tdorssers/Robot2/schematic/Robot2.sch

## EAGLE design schematic/Robot2.sch (2022-09-24)

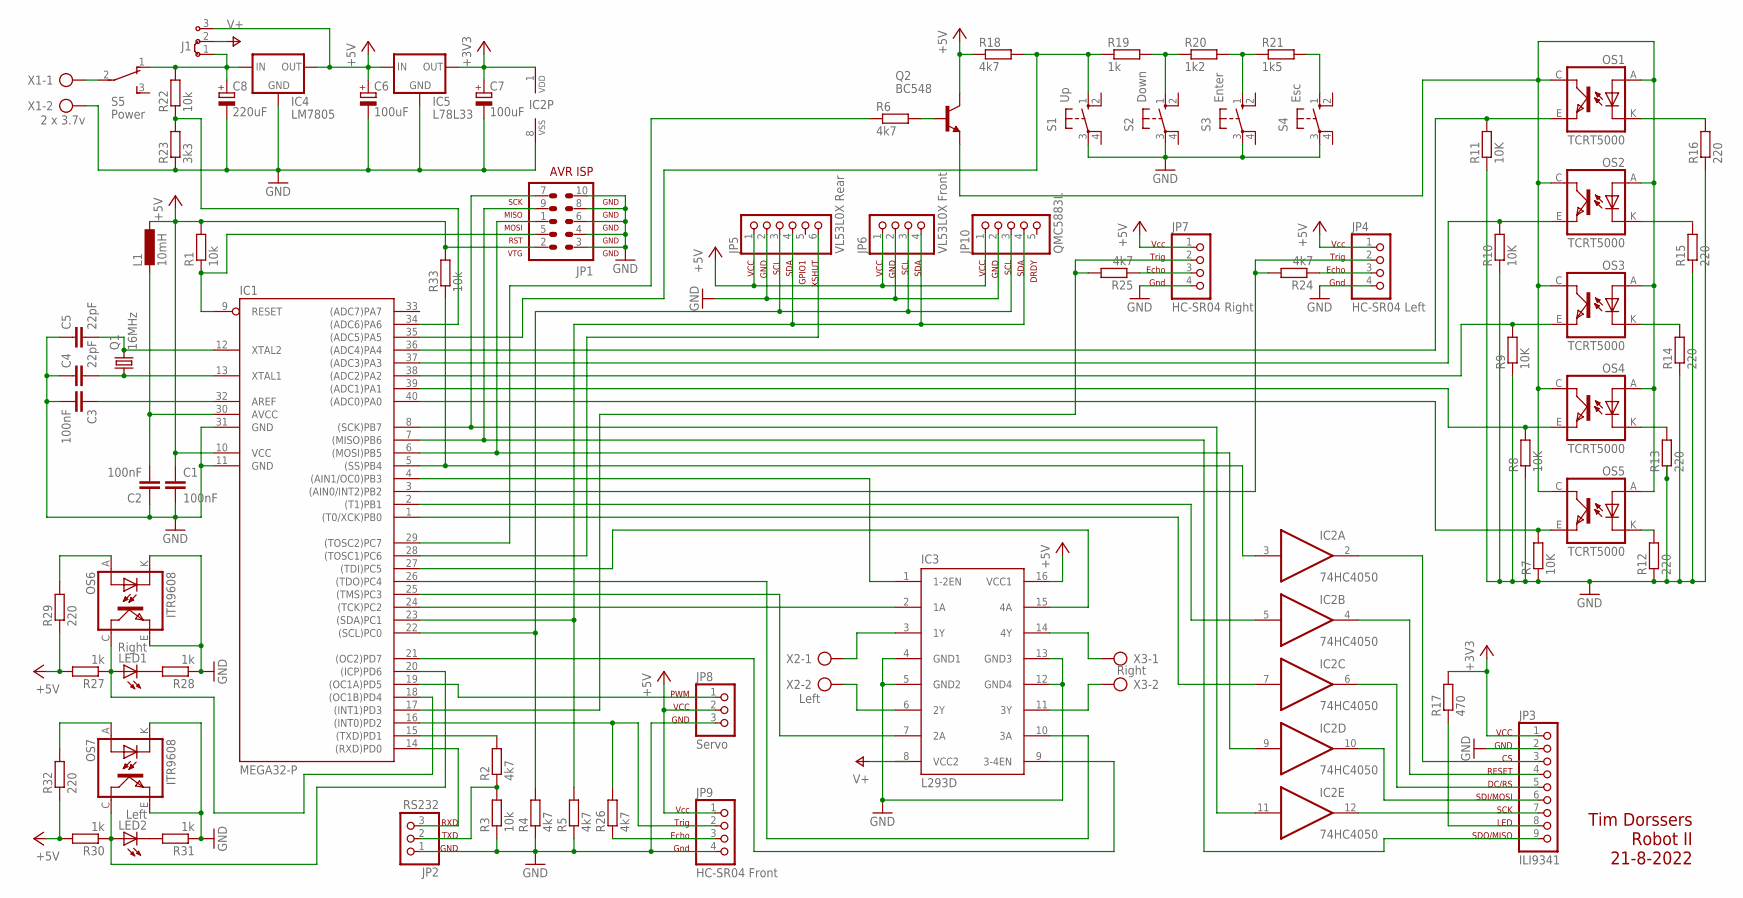
[picture p4: schematic Robot2.sch]

Parts:
C1, C2, C3: 100nF; C050-025X075
C4, C5: 22pF; C025-024X044
C6, C7: 100uF; B45181A
C8: 220uF; B45181A
IC1: MEGA32-P; DIL40
IC2: 74HC4050; DIL16
IC3: L293D; DIL16
IC4: LM7805; 78XXL
IC5: L78L33; 78LXX
J1: J2X2MM; 04C
JP1: AVR-ISP-10
JP2: RS232; 1X03
JP3: ILI9341; 1X09
JP4: HC-SR04 Left; 1X04
JP5: VL53L0X Rear; 1X06
JP6: VL53L0X Front; 1X04
JP7: HC-SR04 Right; 1X04
JP8: Servo; 1X03
JP9: HC-SR04 Front; 1X04
JP10: QMC5883L; 1X05
L1: 10mH; 0207/10
LED1: Right; LED5MM
LED2: Left; LED5MM
OS1, OS2, OS3, OS4, OS5: TCRT5000
OS6, OS7: ITR9608; TCRT5000
Q1: 16MHz; HC49U-V
Q2: BC548; TO92-EBC
R1, R3, R22, R33: 10k; 0207/2V
R2, R4, R5, R6, R18, R24, R25, R26: 4k7; 0207/2V
R7, R8, R9, R10, R11: 10K; 0204/7
R12, R13, R14, R15, R16: 220; 0204/7
R17: 470; 0207/2V
R19, R27, R28, R30, R31: 1k; 0207/2V
R20: 1k2; 0207/2V
R21: 1k5; 0207/2V
R23: 3k3; 0207/2V
R29, R32: 220; 0207/2V
S1: Up; B3F-10XX
S2: Down; B3F-10XX
S3: Enter; B3F-10XX
S4: Esc; B3F-10XX
S5: Power; TL3XPO
X1: 2 x 3.7v; AK300/2
X2: Left; AK300/2
X3: Right; AK300/2

Connections:
+3V3: C7.+, IC2.1 (VDD), IC5.OUT, JP3.1, R17.2
+5V: C1.1, C6.+, IC1.10 (VCC), IC3.16 (VCC1), IC4.OUT, IC5.IN, J1.3, JP1.2, JP4.1, JP5.1, JP6.1, JP7.1, JP8.2, JP9.1, JP10.1, L1.1, Q2.C, R1.2, R18.1, R27.2, R29.1, R30.2, R32.1, R33.2
GND: C1.2, C2.1, C3.2, C4.1, C5.1, C6.-, C7.-, C8.-, IC1.11 (GND), IC1.31 (GND), IC2.8 (VSS), IC3.4 (GND1), IC3.5 (GND2), IC3.12 (GND4), IC3.13 (GND3), IC4.GND, IC5.GND, JP1.3, JP1.4, JP1.6, JP1.8, JP1.10, JP2.1, JP3.2, JP4.4, JP5.2, JP6.2, JP7.4, JP8.3, JP9.4, JP10.2, OS6.E (EMITTER), OS6.K (CATHODE), OS7.E (EMITTER), OS7.K (CATHODE), R3.1, R4.1, R5.1, R7.1, R8.1, R9.1, R10.1, R11.1, R12.1, R13.1, R14.1, R15.1, R16.1, R23.1, R28.1, R31.1, S1.3, S2.3, S3.3, S4.3, X1.2
unnamed: C5.2, IC1.12 (XTAL2), Q1.2
unnamed: C4.2, IC1.13 (XTAL1), Q1.1
unnamed: JP2.2, R2.1, R3.2
unnamed: IC1.29 ((TOSC2)PC7), R6.1
unnamed: C2.2, IC1.30 (AVCC), L1.2
unnamed: IC1.15 ((TXD)PD1), R2.2
unnamed: C3.1, IC1.32 (AREF)
unnamed: IC1.14 ((RXD)PD0), JP2.3
unnamed: IC1.3 ((AIN0/INT2)PB2), JP4.2, R24.2
unnamed: IC1.22 ((SCL)PC0), JP5.3, JP6.3, JP10.3, R4.2
unnamed: IC1.23 ((SDA)PC1), JP5.4, JP6.4, JP10.4, R5.2
unnamed: JP3.8, R17.1
unnamed: Q2.B, R6.2
unnamed: IC1.8 ((SCK)PB7), IC2.11 (I), JP1.7
unnamed: IC1.7 ((MISO)PB6), JP1.9, JP3.9
unnamed: IC1.6 ((MOSI)PB5), IC2.9 (I), JP1.1
unnamed: IC1.9 (RESET), JP1.5, R1.1
unnamed: IC1.36 ((ADC4)PA4), OS1.E (EMITTER), R11.2
unnamed: IC1.37 ((ADC3)PA3), OS2.E (EMITTER), R10.2
unnamed: IC1.38 ((ADC2)PA2), OS3.E (EMITTER), R9.2
unnamed: IC1.39 ((ADC1)PA1), OS4.E (EMITTER), R8.2
unnamed: IC1.40 ((ADC0)PA0), OS5.E (EMITTER), R7.2
unnamed: OS5.K (CATHODE), R12.2
unnamed: OS1.K (CATHODE), R16.2
unnamed: OS2.K (CATHODE), R15.2
unnamed: OS3.K (CATHODE), R14.2
unnamed: OS4.K (CATHODE), R13.2
unnamed: JP4.3, R24.1
unnamed: S5.2, X1.1
unnamed: IC2.6 (O), JP3.5
unnamed: IC2.2 (O), JP3.3
unnamed: IC2.10 (O), JP3.6
unnamed: IC1.34 ((ADC6)PA6), R22.1, R23.2
unnamed: IC2.4 (O), JP3.4
unnamed: IC3.3 (1Y), X2.1
unnamed: IC2.12 (O), JP3.7
unnamed: IC1.5 ((SS)PB4), IC2.3 (I), R33.1
unnamed: IC1.35 ((ADC5)PA5), R18.2, R19.1, S1.1 (S)
unnamed: R19.2, R20.1, S2.1 (S)
unnamed: R20.2, R21.1, S3.1 (S)
unnamed: R21.2, S4.1 (S)
unnamed: IC1.2 ((T1)PB1), IC2.5 (I)
unnamed: IC1.1 ((T0/XCK)PB0), IC2.7 (I)
unnamed: IC1.4 ((AIN1/OC0)PB3), IC3.1 (1-2EN)
unnamed: IC1.21 ((OC2)PD7), IC3.9 (3-4EN)
unnamed: IC1.16 ((INT0)PD2), JP9.2, R26.2
unnamed: IC3.6 (2Y), X2.2
unnamed: IC1.24 ((TCK)PC2), IC3.2 (1A)
unnamed: OS1.A (ANODE), OS1.C (COLLECTOR), OS2.A (ANODE), OS2.C (COLLECTOR), OS3.A (ANODE), OS3.C (COLLECTOR), OS4.A (ANODE), OS4.C (COLLECTOR), OS5.A (ANODE), OS5.C (COLLECTOR), Q2.E
unnamed: IC1.26 ((TDO)PC4), IC3.10 (3A)
unnamed: IC1.17 ((INT1)PD3), JP7.2, R25.2
unnamed: IC1.25 ((TMS)PC3), IC3.7 (2A)
unnamed: IC1.27 ((TDI)PC5), IC3.15 (4A)
unnamed: IC3.14 (4Y), X3.1
unnamed: IC3.11 (3Y), X3.2
unnamed: IC1.28 ((TOSC1)PC6), JP5.6
unnamed: JP7.3, R25.1
unnamed: C8.+, IC4.IN, J1.1, R22.2, S5.1 (O)
unnamed: JP9.3, R26.1
unnamed: IC1.19 ((OC1A)PD5), JP8.1
unnamed: IC1.20 ((ICP)PD6), LED2.A, OS7.C (COLLECTOR), R30.1
unnamed: IC1.18 ((OC1B)PD4), LED1.A, OS6.C (COLLECTOR), R27.1
unnamed: LED2.K (C), R31.2
unnamed: OS6.A (ANODE), R29.2
unnamed: LED1.K (C), R28.2
unnamed: OS7.A (ANODE), R32.2
V+: J1.2

Notes on the sheet:
VCC GND CS RESET DC/RS SDI/MOSI SCK LED SDO/MISO
VCC GND SCL SDA GPIO1 XSHUT
VCC GND SCL SDA
Vcc Trig Echo Gnd
PWM VCC GND
VCC GND SCL SDA DRDY
RXD TXD GND
Tim Dorssers Robot II 21-8-2022
